denispoperechny/audrey/missions/4_waypoint_navigation/index.md

# Mission 4 — Waypoint navigation

Planned.

- Check heading accuracy
- Check rudder doesn't go unbalanced
- Check GPS against the reference
