denispoperechny/audrey/chassis/tug_boat/3d/body/winch_parts.obj

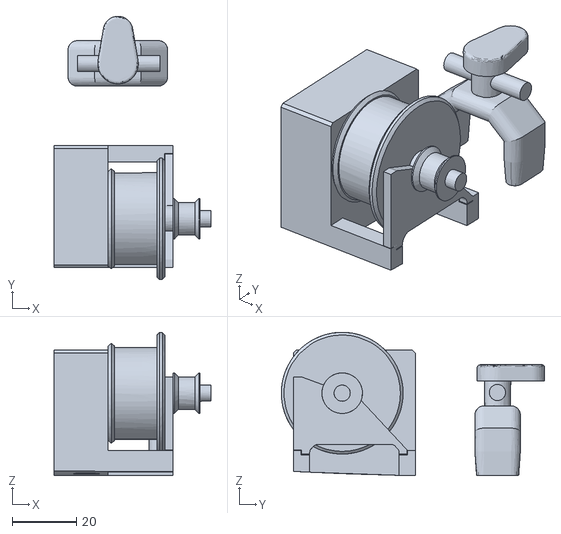
[picture p8: CAD file, 2026-10-31]
chassis/tug_boat/3d/body/winch_parts.obj
48.7 x 81.7 x 44.5
