denispoperechny/audrey/chassis/tug_boat/3d/camera_housing.obj

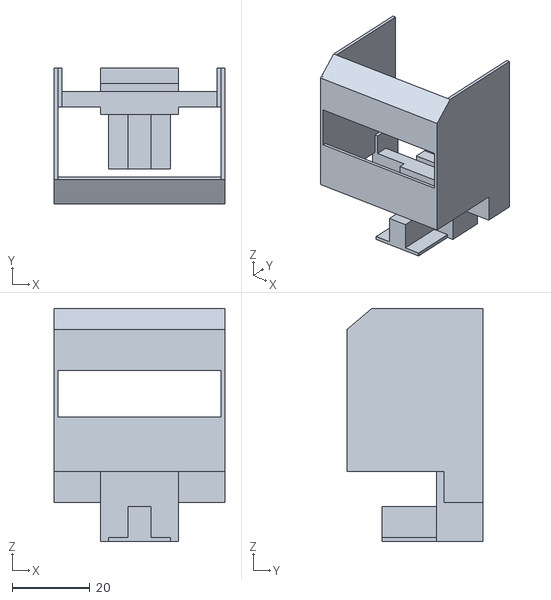
[picture p9: CAD file, 2026-10-31]
chassis/tug_boat/3d/camera_housing.obj
44.0 x 35.0 x 60.0
