denispoperechny/audrey/chassis/tug_boat/3d/battery-mount.obj

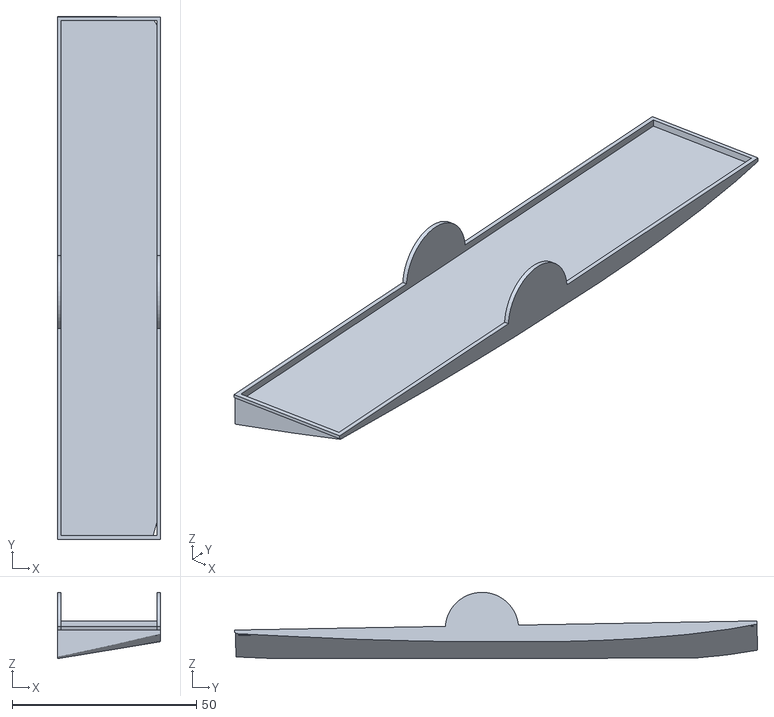
[picture p10: CAD file, 2026-10-11]
chassis/tug_boat/3d/battery-mount.obj
28.0 x 142.1 x 18.0
