denispoperechny/audrey/chassis/tug_boat/3d/body/cabin-base.obj

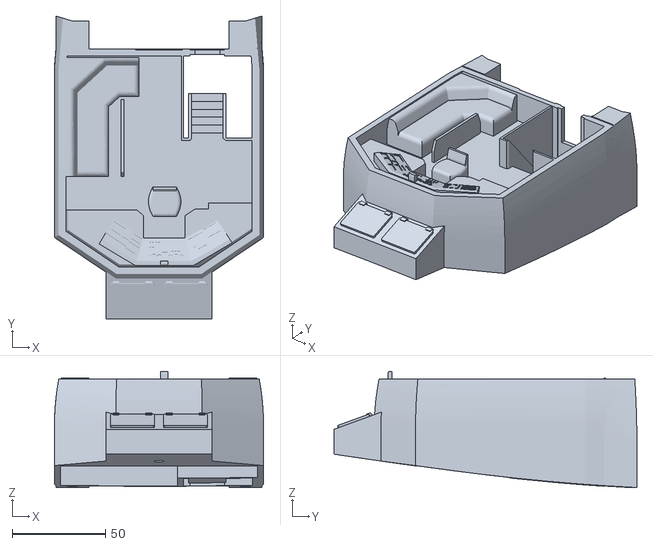
[picture p11: CAD file, 2026-09-07]
chassis/tug_boat/3d/body/cabin-base.obj
112.6 x 162.9 x 62.6
