denispoperechny/audrey/chassis/tug_boat/3d/body/deck.obj

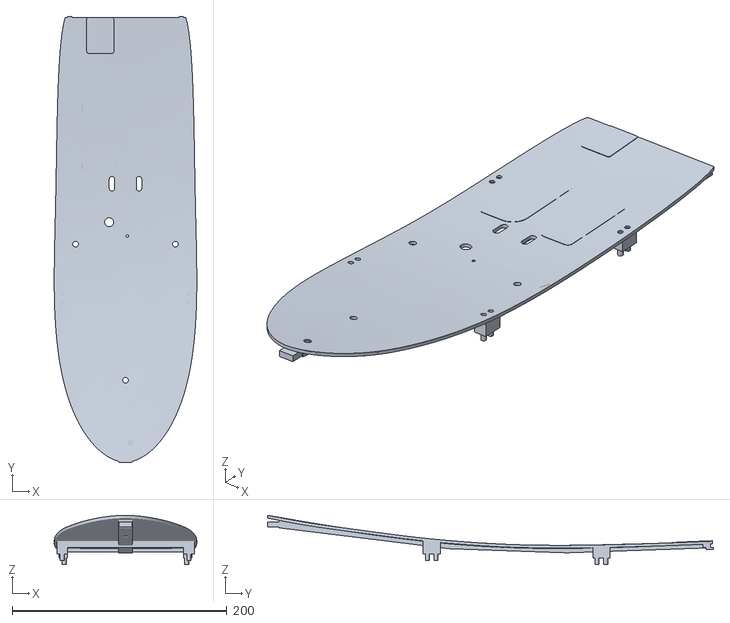
[picture p12: CAD file, 2026-09-07]
chassis/tug_boat/3d/body/deck.obj
132.9 x 415.5 x 45.9
