denispoperechny/audrey/chassis/tug_boat/3d/front_service_bracket.obj

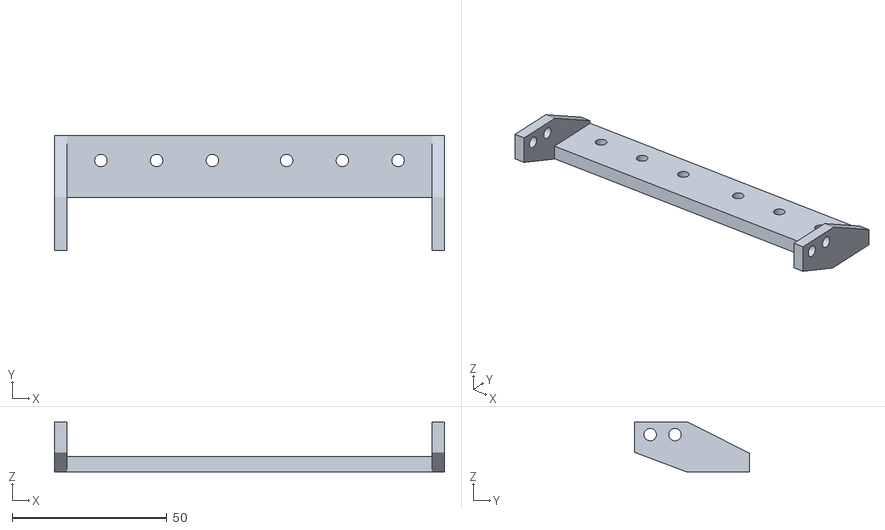
[picture p13: CAD file, 2026-10-11]
chassis/tug_boat/3d/front_service_bracket.obj
126.0 x 37.0 x 16.0
