denispoperechny/audrey/chassis/tug_boat/3d/body/hull.obj

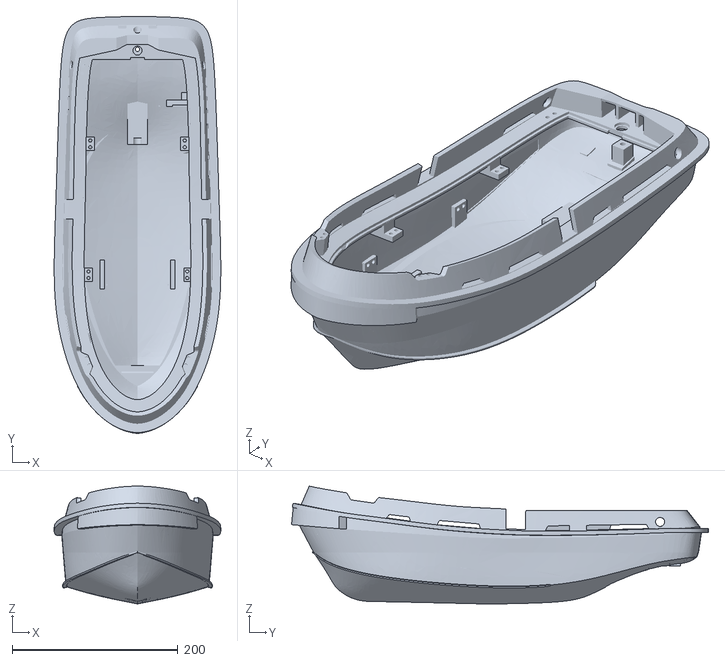
[picture p14: CAD file, 2026-08-29]
chassis/tug_boat/3d/body/hull.obj
201.1 x 503.2 x 142.2
