denispoperechny/audrey/chassis/tug_boat/3d/electronics_mount.obj

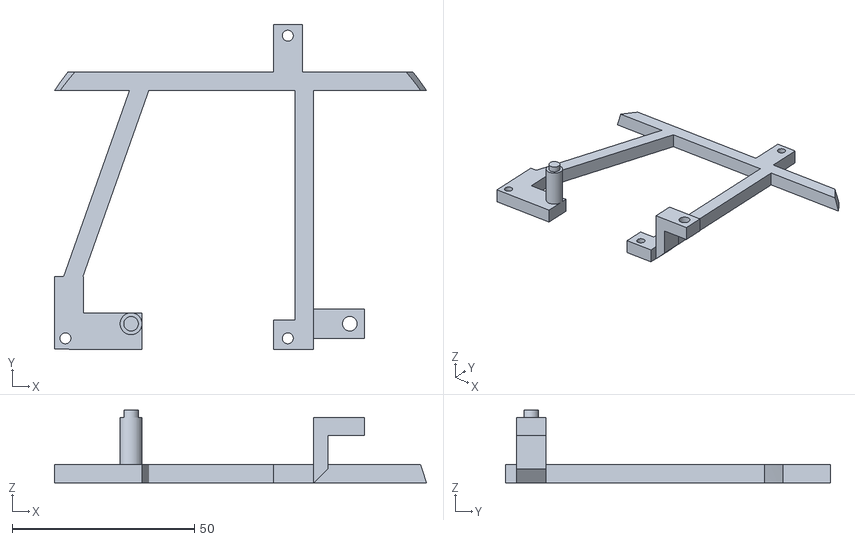
[picture p15: CAD file, 2026-10-11]
chassis/tug_boat/3d/electronics_mount.obj
102.0 x 89.0 x 20.0
