denispoperechny/audrey/chassis/tug_boat/3d/esc_radio_mount.obj

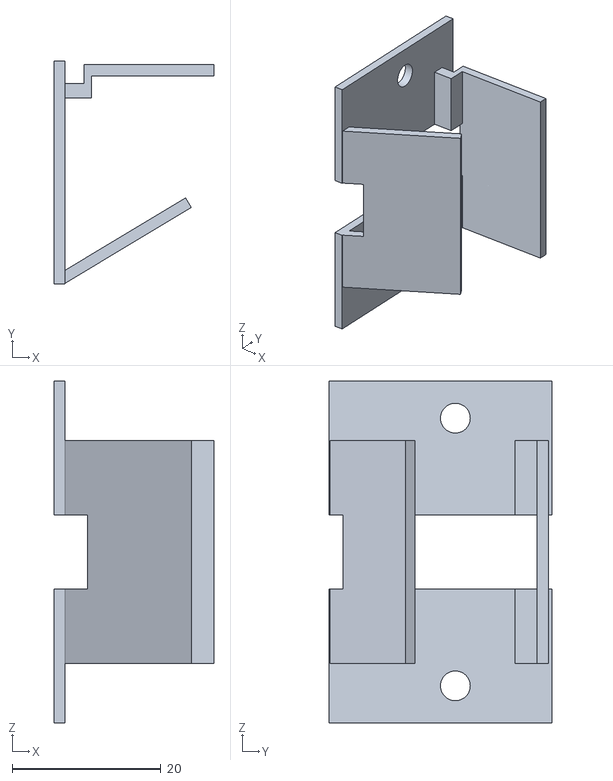
[picture p16: CAD file, 2026-09-17]
chassis/tug_boat/3d/esc_radio_mount.obj
21.5 x 30.0 x 46.0
