denispoperechny/audrey/chassis/tug_boat/3d/drivetrain_template.obj

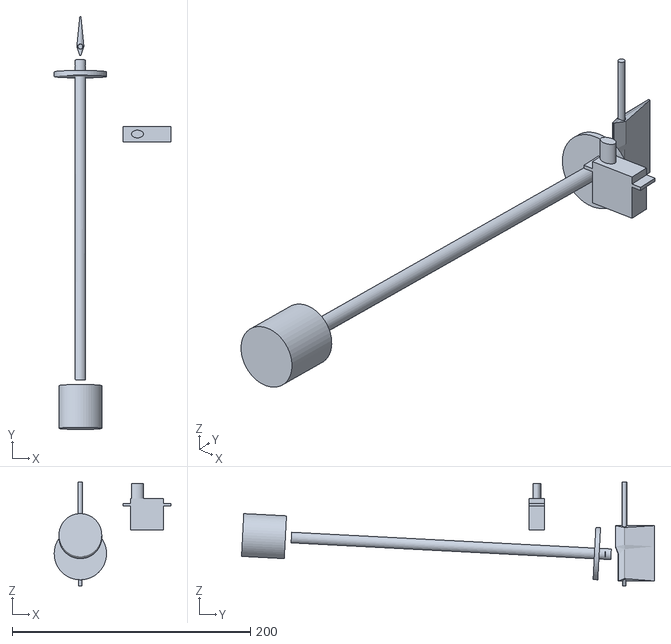
[picture p17: CAD file, 2026-08-29]
chassis/tug_boat/3d/drivetrain_template.obj
98.0 x 347.0 x 87.0
