denispoperechny/audrey/chassis/tug_boat/3d/rudder.obj

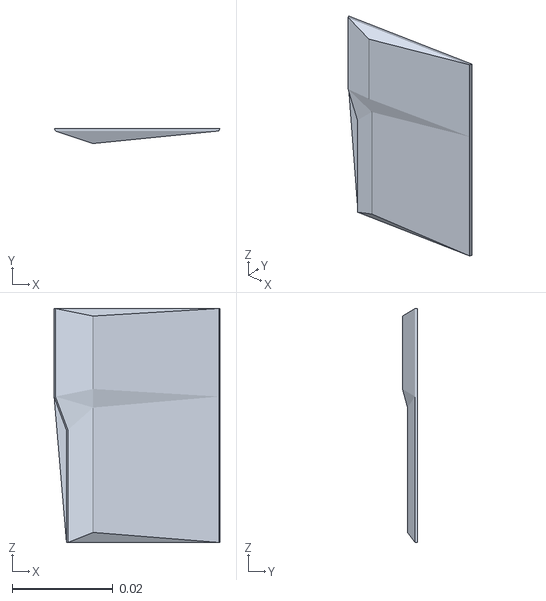
[picture p18: CAD file, 2026-08-29]
chassis/tug_boat/3d/rudder.obj
0.0329 x 0.003 x 0.0465
