denispoperechny/audrey/chassis/tug_boat/3d/motor_bracket.obj

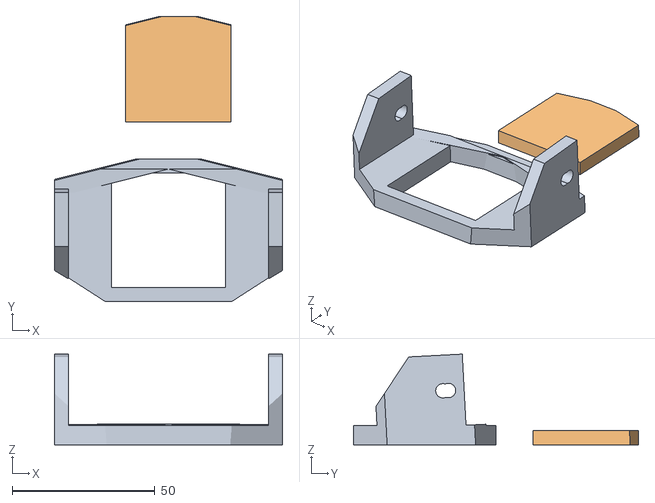
[picture p19: CAD file, 2026-08-29]
chassis/tug_boat/3d/motor_bracket.obj
80.0 x 100.0 x 31.9
obj_0
obj_1
