denispoperechny/audrey/electronics/camera_stream_xiao/src/secrets.example.h

// Copy to secrets.h (not in git) and fill in.
#pragma once

#define WIFI_SSID "your-network"
#define WIFI_PASSWORD "your-password"
#define SERVICE_URL "http://<camera service host>/api"  // plain HTTP; no trailing slash
#define CAMERA_NAME "xiao-1"  // recorded with every picture
