denispoperechny/audrey/(commit log)

2026-08-29 chassis details added
    [drivetrain_template.obj, hull.obj, motor_bracket.obj, rudder.obj]
2026-08-29 deck added
    [deck.obj]
2026-09-07 3d designs updates
    [cabin-base.obj, deck.obj]
2026-09-12 m1 power calcualted power consumption update
2026-09-17 i2c proto added
2026-09-17 es c radio mount 3d add
    [esc_radio_mount.obj]
2026-09-20 main controller py prototype
2026-09-27 bcu failsafe time updated
    [gnc.py, main.py]
2026-10-04 compass moved to uart
2026-10-04 main i2c switched to hardware mode
2026-10-17 ground control software packaged and deployed. UX improved
2026-10-18 virtual compass added and rudder adjustment
2026-10-24 camera software added
2026-10-29 camera speed up
2026-10-31 camera module watchdog added
2026-10-31 camera safety fixes
